snqx-lqh/Stm32RemoteControl/03_Tools/OIP.jpg

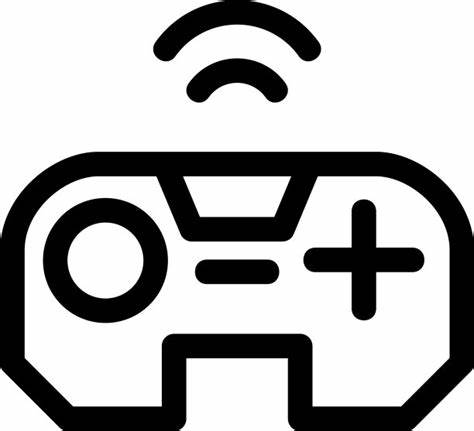
03_Tools/OIP.jpg
