snqx-lqh/Stm32RemoteControl/03_Tools/微信截图_20240109210331.png

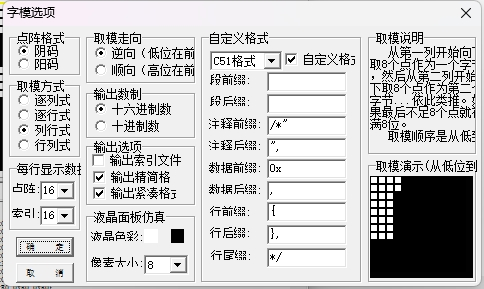
03_Tools/微信截图_20240109210331.png
