snqx-lqh/Stm32RemoteControl/04_Mechanical/关键尺寸图.png

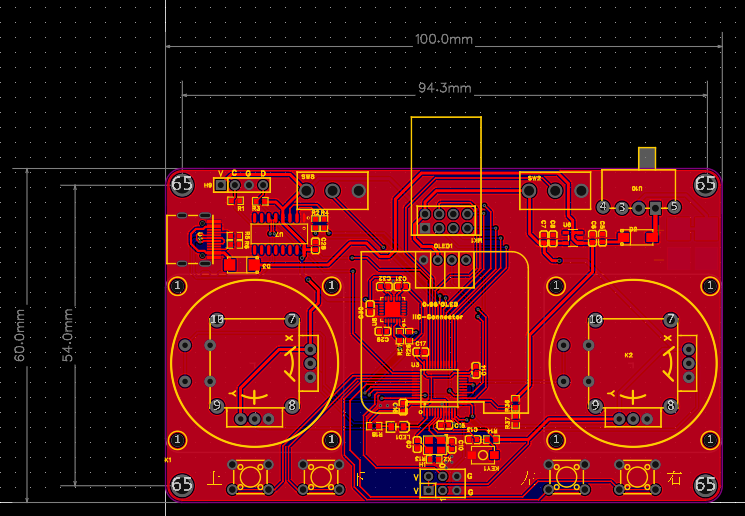
04_Mechanical/关键尺寸图.png
