snqx-lqh/Stm32RemoteControl/SCH_Schematic1_2023-12-03.pdf

# VCCSPI1_CLK

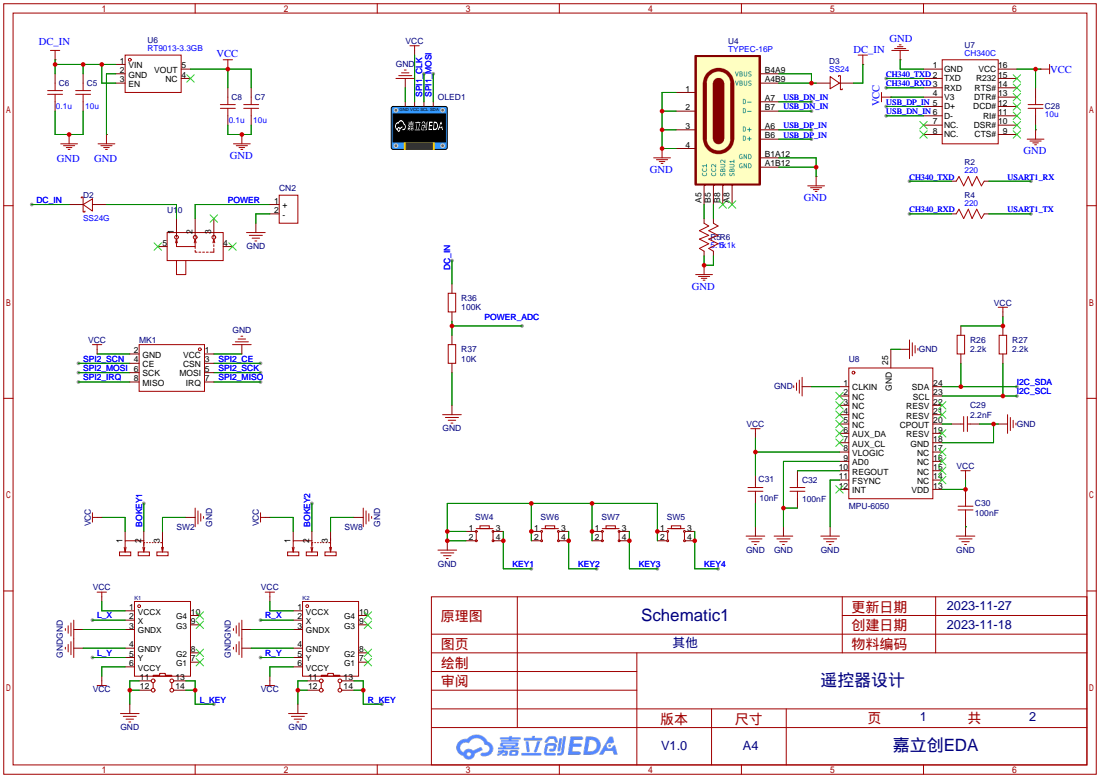
[picture p6: page 1]

GND VCC SCL SDA

# stm32最小系统

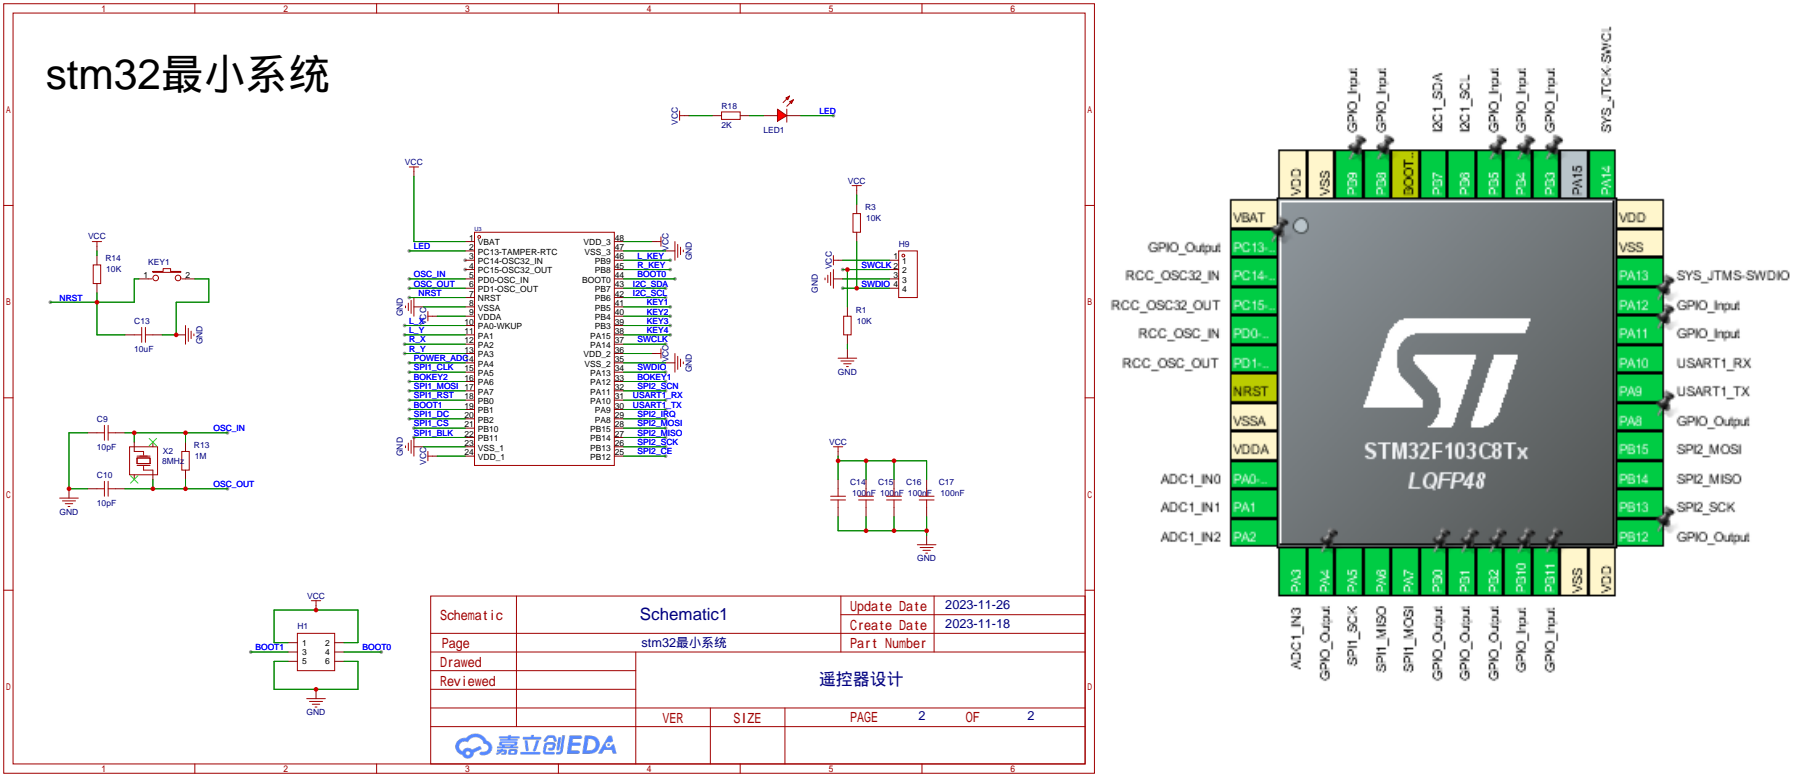
[picture p7: page 2]
