snqx-lqh/Stm32RemoteControl/01_Hardware/遥控器原理图.pdf

# VCCOLED_IIC_SCL

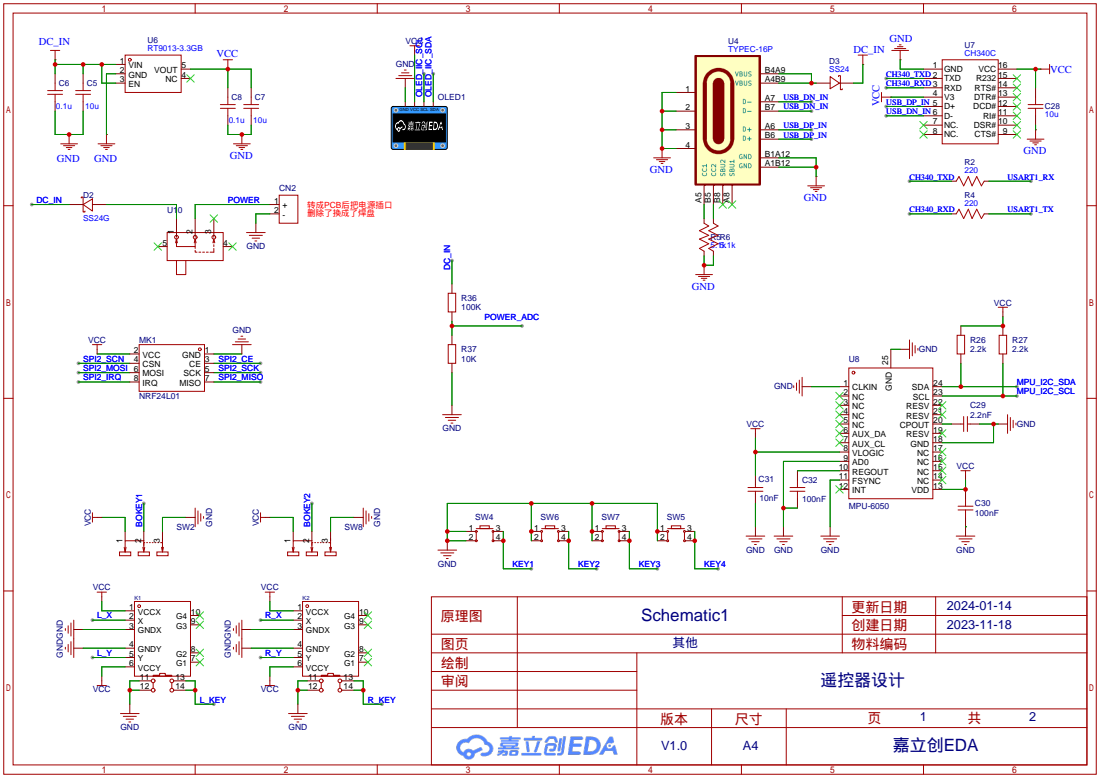
[picture p8: page 1]

GND VCC SCL SDA

# stm32最小系统

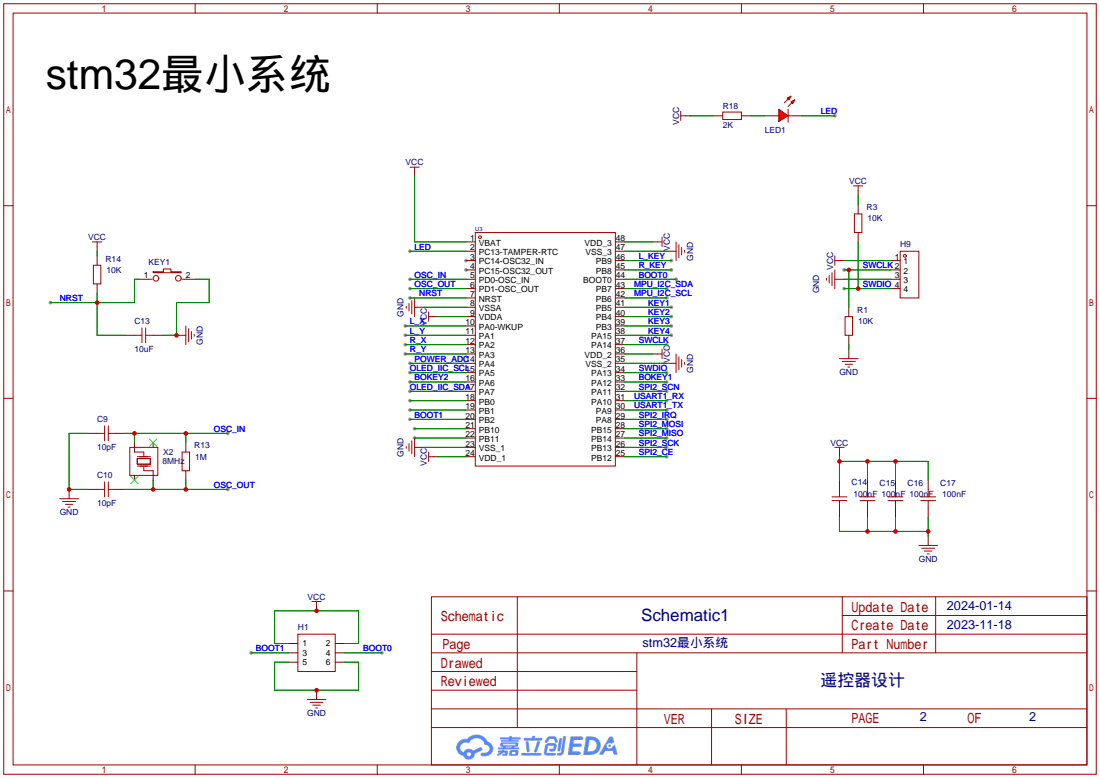
[picture p9: page 2]
