snqx-lqh/Stm32RemoteControl/01_Hardware/NRFLink原理图.pdf

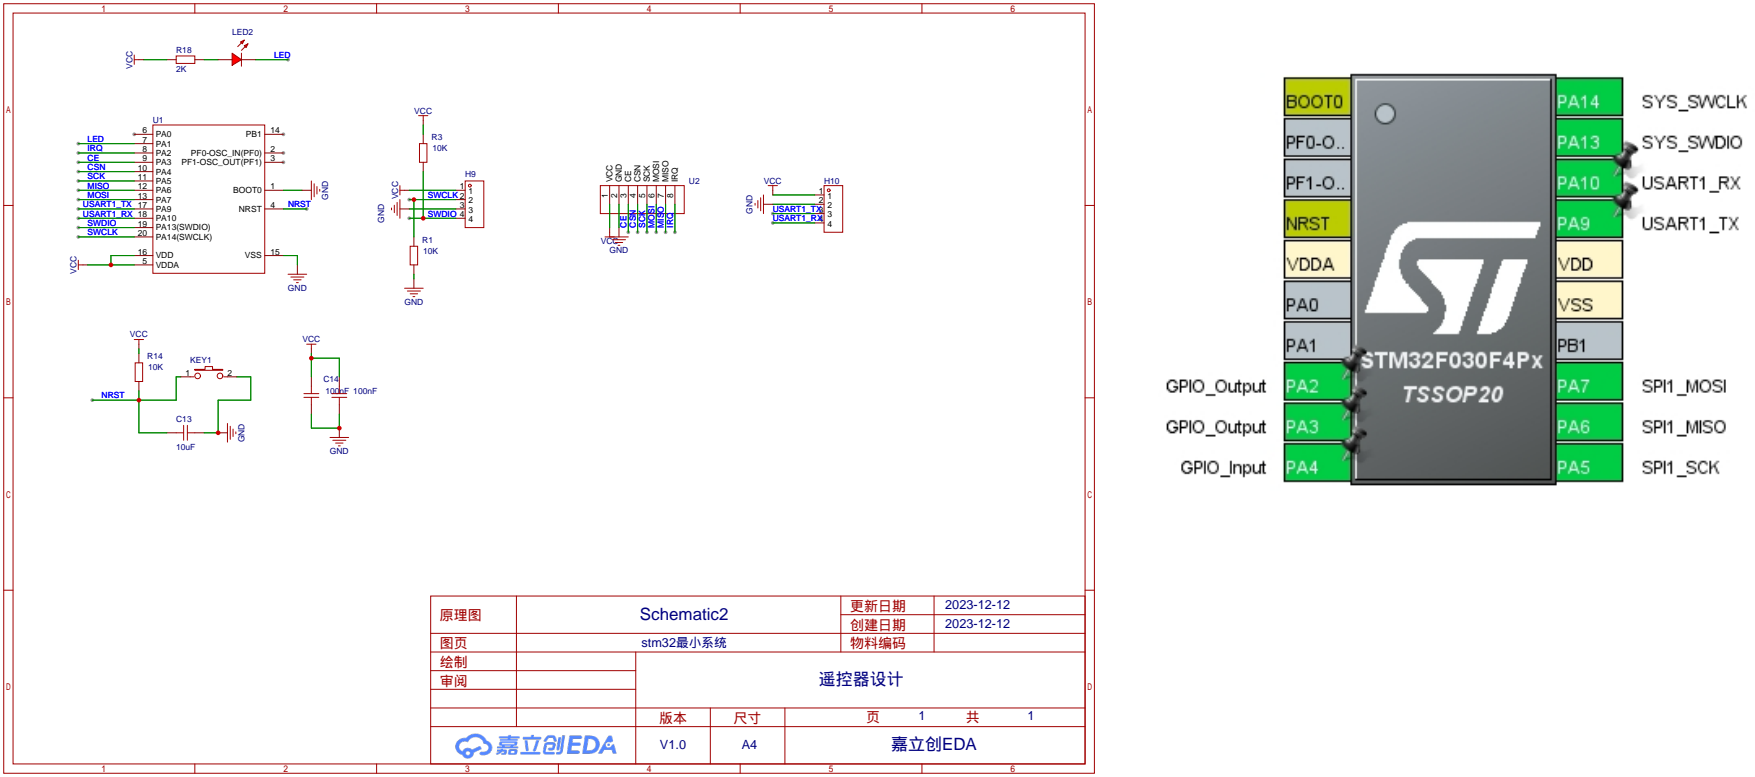
[picture p10: page 1]
