snqx-lqh/Stm32RemoteControl/04_Mechanical/板框图.pdf

V C G D | SW8 | SW2

# R2R4C28

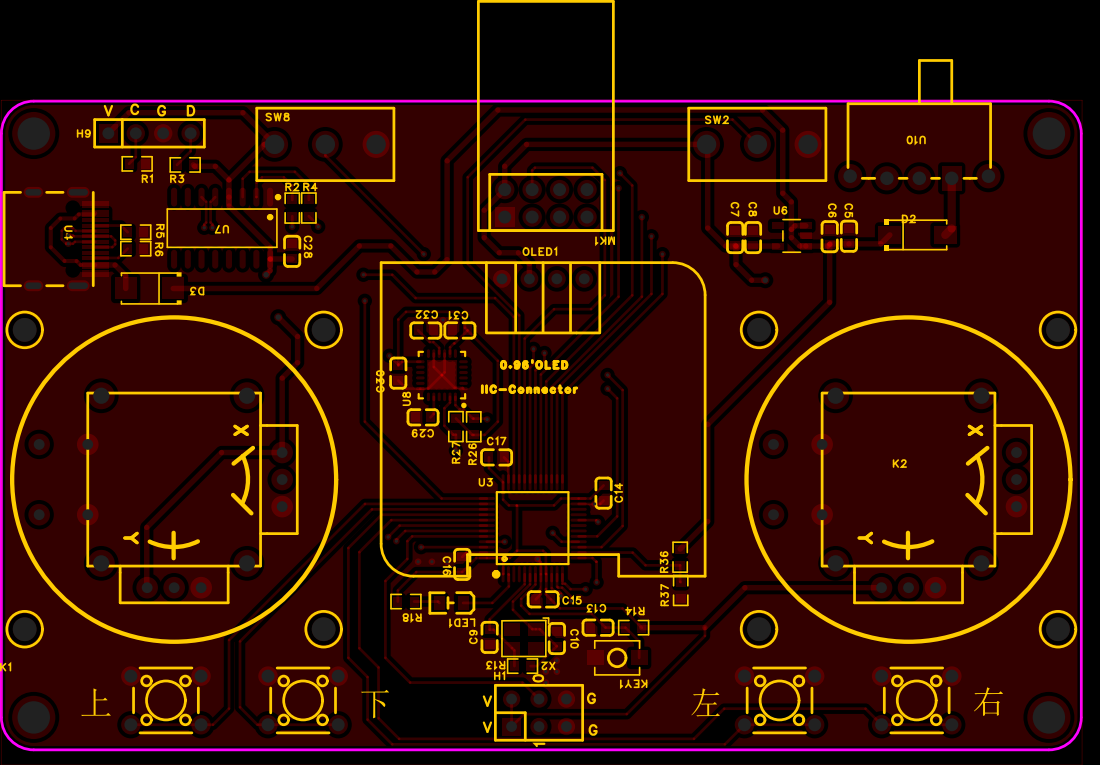
[picture p11: page 1]

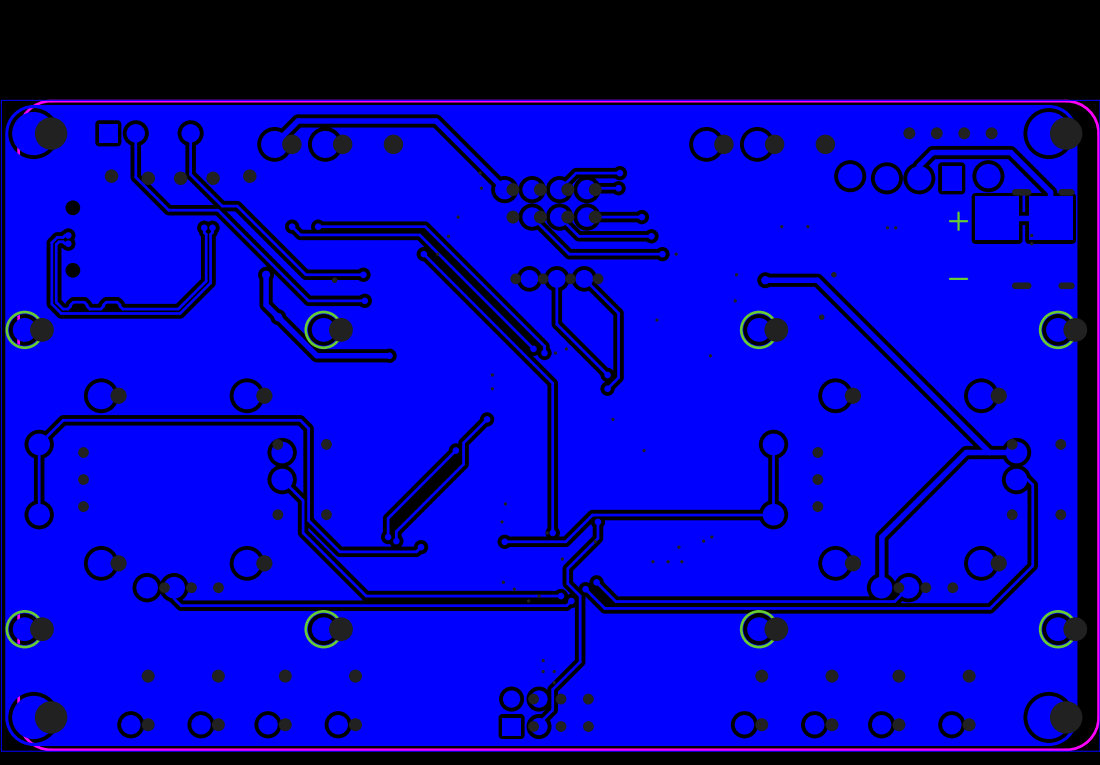
[picture p12: page 2]
