snqx-lqh/Stm32RemoteControl/(list of files, drawings)

Other design files:
01_Hardware/嘉立创专业版_ProDocument_遥控器设计_2024-03-31.epro
