snqx-lqh/Stm32RemoteControl/02_Firmware/NRFLink/Core/Src/main.c

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
/* Includes ------------------------------------------------------------------*/
#include "main.h"
#include "spi.h"
#include "usart.h"
#include "gpio.h"

/* USER CODE BEGIN Includes */
#include "nrf24l01.h"
#include "stdio.h"
/* USER CODE END Includes */


void SystemClock_Config(void);
/* USER CODE BEGIN 0 */
#define RX_BUFF_LEN  32  
uint8_t rxBuff[RX_BUFF_LEN]={0};//定义一个全局变量

void HAL_UART_RxCpltCallback(UART_HandleTypeDef *huart)  
{  
    if(huart->Instance == USART1)//假如有串口1触发接收中断  
    {  
	   HAL_UART_Receive_IT(&huart1,rxBuff,32);  
       HAL_UART_Transmit(&huart1,rxBuff,sizeof(rxBuff),100);
    }  
        
}


int16_t check_nrf = 0;
uint8_t check_rx = 0;
uint8_t nrf_test[32] = {0};
uint8_t nrf_tx_buff[32] ="hello world";

/* USER CODE END 0 */

/**
  * @brief  The application entry point.
  * @retval int
  */
int main(void)
{
  /* MCU Configuration--------------------------------------------------------*/

  /* Reset of all peripherals, Initializes the Flash interface and the Systick. */
  HAL_Init();

  /* Configure the system clock */
  SystemClock_Config();

  /* Initialize all configured peripherals */
  MX_GPIO_Init();
  MX_SPI1_Init();
  MX_USART1_UART_Init();
  /* USER CODE BEGIN 2 */
	__HAL_UART_ENABLE_IT(&huart1,UART_IT_RXNE);
	HAL_UART_Receive_IT(&huart1,rxBuff,32); 
	NRF24L01_Init();
	check_nrf = NRF24L01_Check();
	NRF24L01_RX_Mode();
  /* USER CODE END 2 */

  /* Infinite loop */
  /* USER CODE BEGIN WHILE */
  while (1)
  {
    /* USER CODE END WHILE */

    /* USER CODE BEGIN 3 */
//	  NRF24L01_TxPacket(nrf_tx_buff);
//	  HAL_Delay(1000);
	if(NRF24L01_RxPacket(nrf_test)==0)//一旦接收到信息,则发送出来.
	{
		HAL_UART_Transmit(&huart1,nrf_test,sizeof(nrf_test),100);
		
	}
//	PAout(2) = 0;
//	HAL_Delay(1000);
//	PAout(2) = 1;
//	HAL_Delay(1000);
//	printf("hello\r\n");
	//HAL_Delay(20);
  }
  /* USER CODE END 3 */
}

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
