snqx-lqh/Stm32RemoteControl/02_Firmware/NRFLink/NRFLink.ioc

Mcu.UserName=STM32F030F4Px
PA1.Signal=GPIO_Output
PA10.Signal=USART1_RX
PA13.Signal=SYS_SWDIO
PA14.Signal=SYS_SWCLK
PA2.Signal=GPIO_Input
PA3.Signal=GPIO_Output
PA4.Signal=GPIO_Output
PA5.Signal=SPI1_SCK
PA6.Signal=SPI1_MISO
PA7.Signal=SPI1_MOSI
PA9.Signal=USART1_TX
