snqx-lqh/Stm32RemoteControl/02_Firmware/CodeTxFreeRtos/Project/main.h

#ifndef _MAIN_H
#define _MAIN_H

#include "stm32f10x.h"

#include "stdio.h"
#include "string.h"

#include "bsp_sys.h"

#include "FreeRTOSConfig.h"
#include "FreeRTOS.h"
#include "task.h"

#define fp32 float

#define NULL 0

#define PI 3.14

#define  CONFIG_LETTER_SHELL_ENABLE 0
#define  CONFIG_ANO_ENABLE          0

#endif
