snqx-lqh/Stm32RemoteControl/02_Firmware/CodeRx/USER/BSP/bsp_key.c

#include "bsp_key.h"

void bsp_key_init()
{
    //打开时钟
	RCC_APB2PeriphClockCmd(RCC_APB2Periph_GPIOA,ENABLE);
	RCC_APB2PeriphClockCmd(RCC_APB2Periph_GPIOB,ENABLE);
	//关闭JTAG
	RCC_APB2PeriphClockCmd(RCC_APB2Periph_AFIO ,ENABLE);
	GPIO_PinRemapConfig(GPIO_Remap_SWJ_JTAGDisable, ENABLE);
    
	//初始化IO口
    {
        GPIO_InitTypeDef GPIO_InitStruct;

        GPIO_InitStruct.GPIO_Pin  = GPIO_Pin_15;
        GPIO_InitStruct.GPIO_Mode = GPIO_Mode_IPU;

        GPIO_Init(GPIOA,&GPIO_InitStruct);
		
		GPIO_InitStruct.GPIO_Pin  = GPIO_Pin_3|GPIO_Pin_4|GPIO_Pin_5;
		
		GPIO_Init(GPIOB,&GPIO_InitStruct);
    }
}
