snqx-lqh/Stm32RemoteControl/02_Firmware/CodeTxFreeRtos/USER/APP/GUI.h

#ifndef _GUI_H
#define _GUI_H

#include "main.h"

struct MenuProperty_t
{
	u8 MenuLen;//当前菜单页菜单个数
	u8 scrollBarLen;//滚动条长度,由于都是用的16SIZE的字符，所以一个菜单页最多四个菜单，五个菜单滚动条就为1
};

//菜单结构体
struct Menu_t{
	struct MenuProperty_t *MenuProperty;
	u8 name[15];//当前菜单的名字
	u8 displayString[15];//当前菜单的字符
	void (*func1) (void);//当前菜单的功能函数
	void (*func2) (void);//当前菜单的功能函数
	struct Menu_t *fatherMenu;//当前菜单的父级菜单
	struct Menu_t *childrenMenu;//当前菜单的子级菜单	
};

struct gui_operations {
	void (*userGuiInit)(void);
	void (*userMainSet)(void);
	void (*userGuiDataDisplayRefresh)(struct Menu_t *menuPoint);
	char *main_ui_name;
	int  (*guiGetValue)(void);
};

void gui_operations_register(struct gui_operations *gui_oper);
void GuiInit(void);
void GuiKeyControl(void);
void DisplayRefreash(struct Menu_t *nowMenu);

#endif
