snqx-lqh/Stm32RemoteControl/(commit log)

2024-01-01 “1-1”
2024-01-14 修改硬件相关
2024-03-31 修改文档
    [嘉立创专业版_ProDocument_遥控器设计_2024-03-31.epro]
2024-08-09 readme修改
2024-10-04 重新分了下文件管理
    [嘉立创专业版_ProDocument_遥控器设计_2024-03-31.epro]
2025-04-09 修改了NRF协议
